HardwareBreakout/BluetoothLowEnergyBoosterPack/Hardware/BLE Booster V3_0.jpg

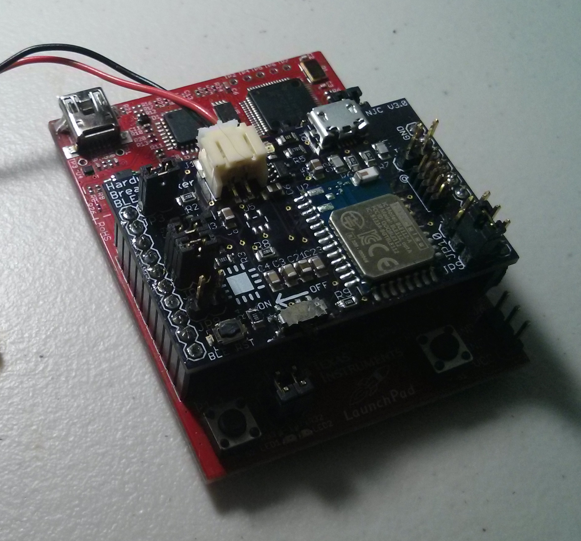
Hardware/BLE Booster V3_0.jpg
