HardwareBreakout/BluetoothLowEnergyBoosterPack/Hardware/BLE Booster 00 V2_0.jpg

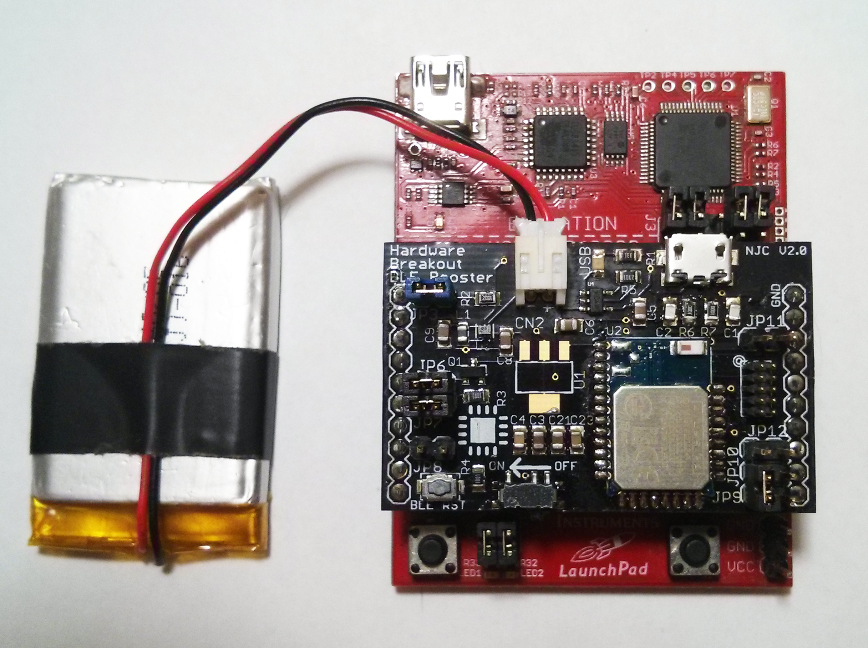
Hardware/BLE Booster 00 V2_0.jpg
