HardwareBreakout/BluetoothLowEnergyBoosterPack/Hardware/Footprint BLE BoosterPack V3_1.pdf

## PCB Footprint: Bluetooth Low Energy BoosterPack – V3.1

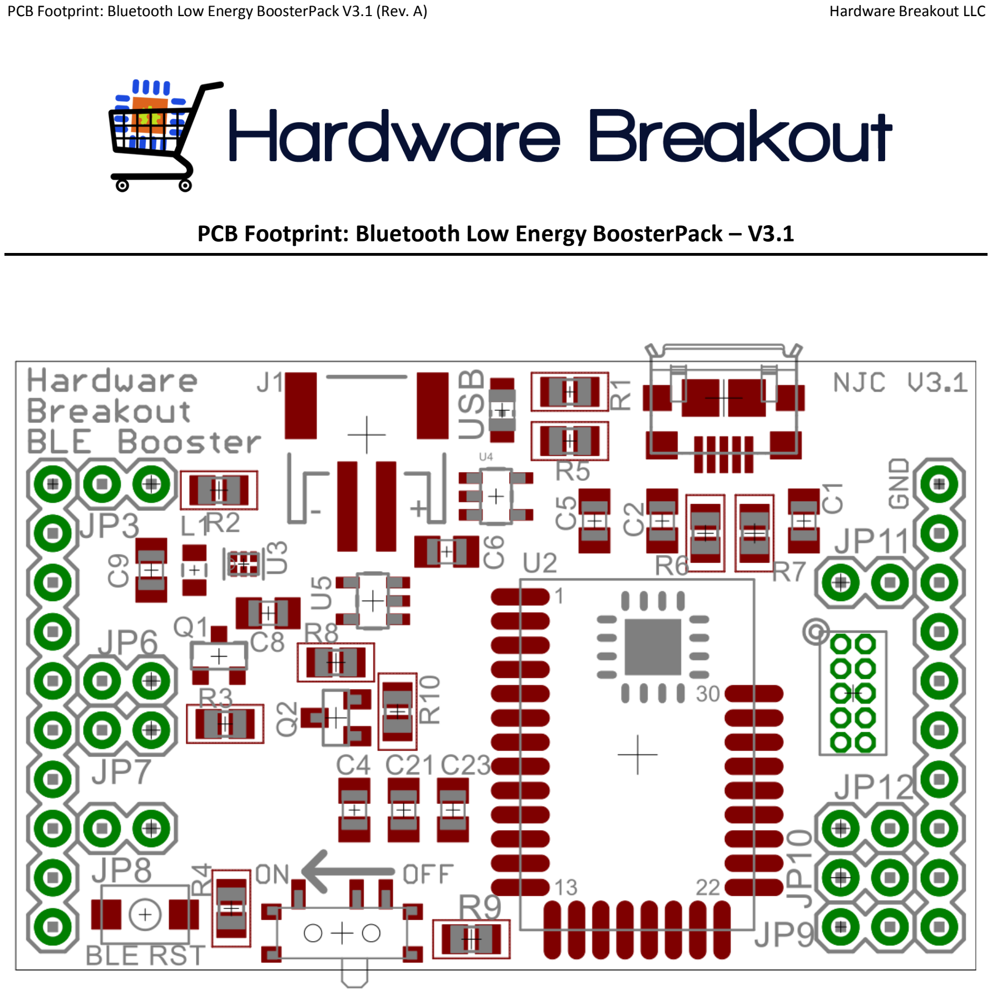
[picture p3: page 1]

PCB Footprint: Bluetooth Low Energy BoosterPack V3.1 (Rev. A) | Hardware Breakout LLC
