HardwareBreakout/BluetoothLowEnergyBoosterPack/Hardware/Footprint BLE BoosterPack V3_0.pdf

## PCB Footprint: Bluetooth Low Energy BoosterPack – V3.0

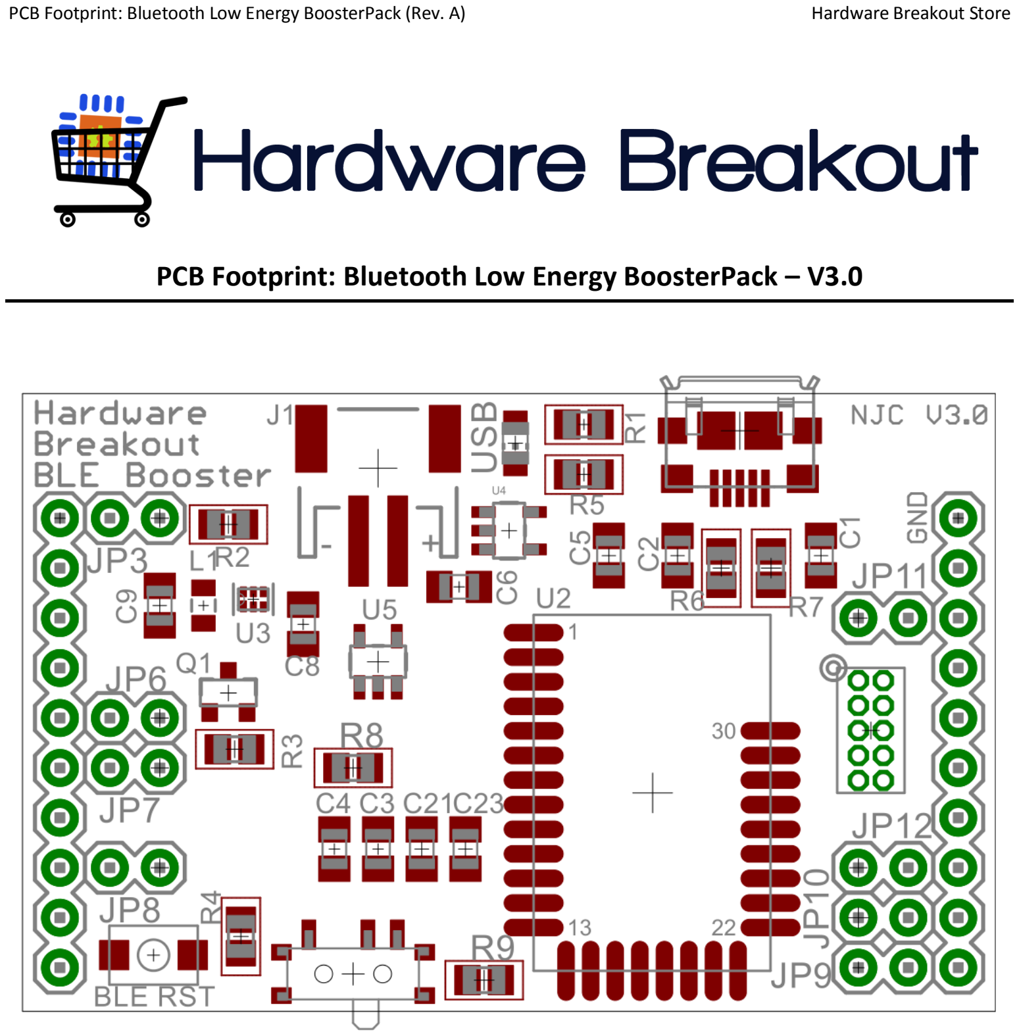
[picture p4: page 1]

PCB Footprint: Bluetooth Low Energy BoosterPack (Rev. A) | Hardware Breakout Store
