HardwareBreakout/BluetoothLowEnergyBoosterPack/Android Example App/BluetoothLowEnergyDemo/ic_launcher-web.png

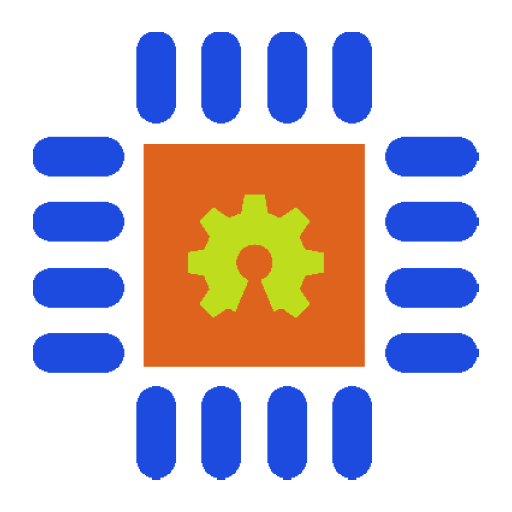
Android Example App/BluetoothLowEnergyDemo/ic_launcher-web.png
