HardwareBreakout/BluetoothLowEnergyBoosterPack/Hardware/BLE Booster 01 V3_0.jpg

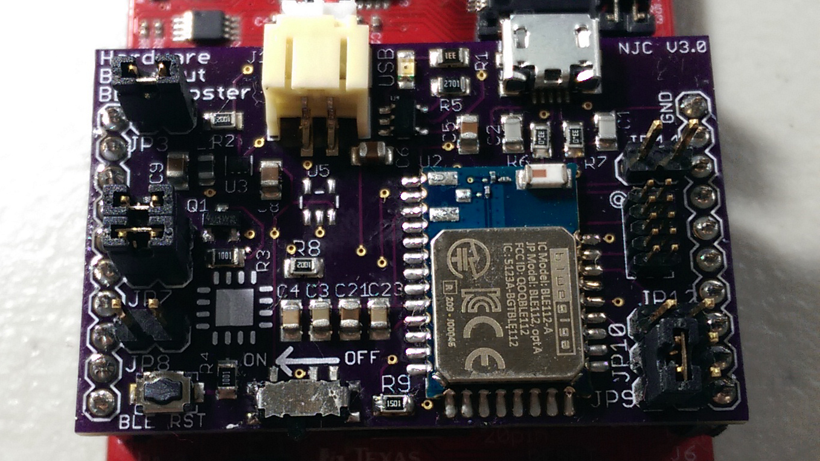
Hardware/BLE Booster 01 V3_0.jpg
