HardwareBreakout/BluetoothLowEnergyBoosterPack/Pinout V3_0.png

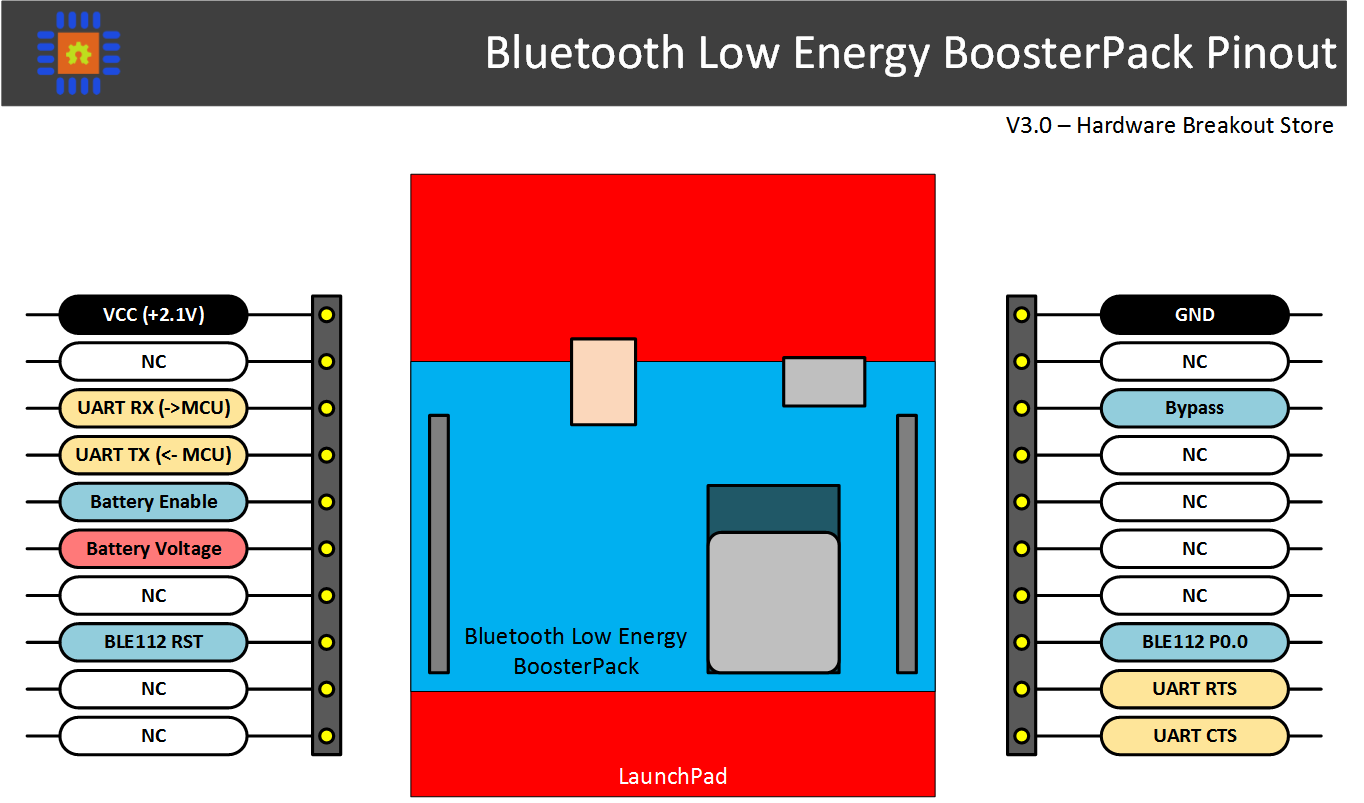
Pinout V3_0.png
