HardwareBreakout/BluetoothLowEnergyBoosterPack/Hardware/BOM BLE BoosterPack V3_1.xlsx

Description | Value | Mouser Number
Capacitor 0805 | 0.001uF
Capacitor 0805 | 0.1uF
Capacitor 0805 | 2.2uF
Capacitor 0805 | 4.7uF
Capacitor 0805 | 47pF
Resistor 0805 | 33R
Resistor 0805 | 330R
Resistor 0805 | 1.5k
Resistor 0805 | 2k
Resistor 0805 | 10k
Inductor | 2.2uH | 810-MLZ2012A2R2W
LED | Red | 720-LHR974-LP-1
Transistor | PMOS | 771-PMV160UP215
Transistor | NMOS | 771-NX3008NBK,215
Switch | Toggle | 688-SSSS810701
Switch | Push | 612-TL1015AF
Connector | 0.05" 2x5 | 649-221111-00010T4LF
Connector | uUSB | 649-10118192-0001LF
Connector | LiPo | 455-1749-1-ND (DigiKey)
Header | Female 1x10 | 992-10FX1-254MM
Header | 8x 2 pin jump | 649-68000-236HLF
Regulator | LP5907 3.3V | LP5907MFX-3.3/NOPB
Regulator | TPS62730 | 595-TPS62730DRYT
Charger | MCP73831 | 579-MCP73831T-2ACIOT
Bluetooth | BLE112 | 603-BLE112-A
Jumper | 2 Pin | 806-SX1100-B
