HardwareBreakout/BluetoothLowEnergyBoosterPack/Hardware/BOM V3_0.xlsx

Sheet: V1
Description | Value | Total Quantity | Mouser Number | Unit Cost | Full Board | Cost | LDO | Cost | BLE Only | Cost | Notes | Unit Cost 50 | Full Board 50 | Cost
Capacitor | 0.001uF | 1 |  | $0.06 | 1 | $0.06 | 1 | $0.06 | 1 | $0.06 |  | $0.04 | 1 | $0.04
Capacitor | 0.1uF | 1 |  | $0.06 | 1 | $0.06 | 1 | $0.06 | 1 | $0.06 |  | $0.04 | 1 | $0.04
Capacitor | 1uF | 1 |  | $0.06 | 1 | $0.06 | 1 | $0.06 | 1 | $0.06 |  | $0.04 | 1 | $0.04
Capacitor | 2.2uF | 2 |  | $0.06 | 2 | $0.12 | 2 | $0.12 | 1 | $0.06 |  | $0.04 | 2 | $0.07
Capacitor | 4.7uF | 3 |  | $0.06 | 3 | $0.18 | 3 | $0.18 | 1 | $0.06 |  | $0.04 | 3 | $0.11
Resistor | 330R | 1 |  | $0.08 | 1 | $0.08 | 1 | $0.08 | 1 | $0.08 |  | $0.01 | 1 | $0.01
Resistor | 1k | 2 |  | $0.08 | 2 | $0.16 | 2 | $0.16 | 0 | $0.00 |  | $0.01 | 2 | $0.02
Resistor | 2k | 1 |  | $0.08 | 1 | $0.08 | 1 | $0.08 | 0 | $0.00 |  | $0.01 | 1 | $0.01
Resistor | 10k | 1 |  | $0.08 | 1 | $0.08 | 0 | $0.00 | 0 | $0.00 |  | $0.01 | 1 | $0.01
Inductor | 2.2uH | 1 | 810-MLZ2012A2R2W | $0.13 | 1 | $0.13 | 0 | $0.00 | 0 | $0.00 |  | $0.10 | 1 | $0.10
LED | Red | 1 | 720-LHR974-LP-1 | $0.10 | 1 | $0.10 | 1 | $0.10 | 0 | $0.00 |  | $0.04 | 1 | $0.04
Transistor | PMOS | 1 | 771-PMV160UP215 | $0.07 | 1 | $0.07 | 1 | $0.07 | 0 | $0.00 |  | $0.07 | 1 | $0.07
Switch | Toggle | 1 | 688-SSSS810701 | $0.37 | 1 | $0.37 | 1 | $0.37 | 0 | $0.00 |  | $0.31 | 1 | $0.31
Switch | Push | 1 | 612-TL1015AF | $0.66 | 1 | $0.66 | 1 | $0.66 | 1 | $0.66 |  | $0.53 | 1 | $0.53
Connector | 0.05" 2x5 | 1 | 649-221111-00010T4LF | $0.70 | 1 | $0.70 | 1 | $0.70 | 1 | $0.70 |  | $0.58 | 1 | $0.58
Connector | uUSB | 1 | 649-10118192-0001LF | $0.35 | 1 | $0.35 | 1 | $0.35 | 0 | $0.00 |  | $0.29 | 1 | $0.29
Connector | LiPo | 1 | SparkFun PRT-0861 | $0.95 | 1 | $0.95 | 1 | $0.95 | 0 | $0.00 | Find at Mouser or Digikey | $0.86 | 1 | $0.86
Header | Female 1x10 | 2 | 992-10FX1-254MM | $0.70 | 2 | $1.40 | 2 | $1.40 | 2 | $1.40 | Find Stackable if possible | $0.68 | 2 | $1.37
Header | 2x8 | 1 | 649-77313-418-16LF | $0.44 | 1 | $0.44 | 1 | $0.44 | 1 | $0.44 | Look for larger ones for production | $0.36 | 1 | $0.36
Regulator | TLV1117 | 0 | 595-TLV1117-50CDCYR | $0.64 | 0 | $0.00 | 1 | $0.64 | 0 | $0.00 |  | $0.38 | 0 | $0.00
Regulator | TPS62730 | 1 | 595-TPS62730DRYT | $1.96 | 1 | $1.96 | 0 | $0.00 | 0 | $0.00 |  | $1.37 | 1 | $1.37
Charger | MCP73831 | 1 | 579-MCP73831T-2ACIOT | $0.60 | 1 | $0.60 | 1 | $0.60 | 0 | $0.00 |  | $0.47 | 1 | $0.47
Bluetooth | BLE112 | 1 | 603-BLE112-A | $14.80 | 1 | $14.80 | 1 | $14.80 | 1 | $14.80 |  | $14.25 | 1 | $14.25
Jumper | 2 Pin | 8 | 806-SX1100-B | $0.03 | 8 | $0.24 | 8 | $0.24 | 5 | $0.15 |  | $0.02 | 8 | $0.16
PCB | 1.975x1.075 in | 1 | OSH Park Medium Run | $3.05 | 1 | $3.05 | 1 | $3.05 | 1 | $3.05 | This is for 150 in sq minimum | $3.05 | 1 | $3.05
Shipping | Cost + Package | 1 | USPS | $3.00 | 1 | $3.00 | 1 | $3.00 | 1 | $3.00 |  | $3.00 | 1 | $3.00
 |  |  |  |  |  | $29.70 |  | $28.17 |  | $24.58 |  |  |  | $27.12
 | Full Board | LDO | BLE Only | T-Shirt
Total Unit Cost | $29.70 | $28.17 | $24.58 | $10.20
Sell Price | $60.00 | 50 | $35.00 | $20.00
Profit | $30.30 | $21.83 | $10.42 | $9.80
Percent Profit | 50.5% | 43.66% | 29.77142857% | 49%

Sheet: V2
Description | Value | Mouser Number
Capacitor 0805 | 0.001uF
Capacitor 0805 | 0.1uF
Capacitor 0805 | 1uF
Capacitor 0805 | 2.2uF
Capacitor 0805 | 4.7uF
Capacitor 0805 | 47pF
Resistor 0805 | 33R
Resistor 0805 | 330R
Resistor 0805 | 1k
Resistor 0805 | 2k
Resistor 0805 | 10k
Inductor | 2.2uH | 810-MLZ2012A2R2W
LED | Red | 720-LHR974-LP-1
Transistor | PMOS | 771-PMV160UP215
Switch | Toggle | 688-SSSS810701
Switch | Push | 612-TL1015AF
Connector | 0.05" 2x5 | 649-221111-00010T4LF
Connector | uUSB | 649-10118192-0001LF
Connector | LiPo | 455-1749-1-ND (DigiKey)
Header | Female 1x10 | 992-10FX1-254MM
Header | 8x 2 pin jump | 649-68000-236HLF
Regulator | LP5907 3.3V | LP5907MFX-3.3/NOPB
Regulator | TPS62730 | 595-TPS62730DRYT
Charger | MCP73831 | 579-MCP73831T-2ACIOT
Bluetooth | BLE112 | 603-BLE112-A
Jumper | 2 Pin | 806-SX1100-B
