HardwareBreakout/BluetoothLowEnergyBoosterPack/Trinket Pro Shield/Pro Trinket BLE Shield V1_0 - Schematic.pdf

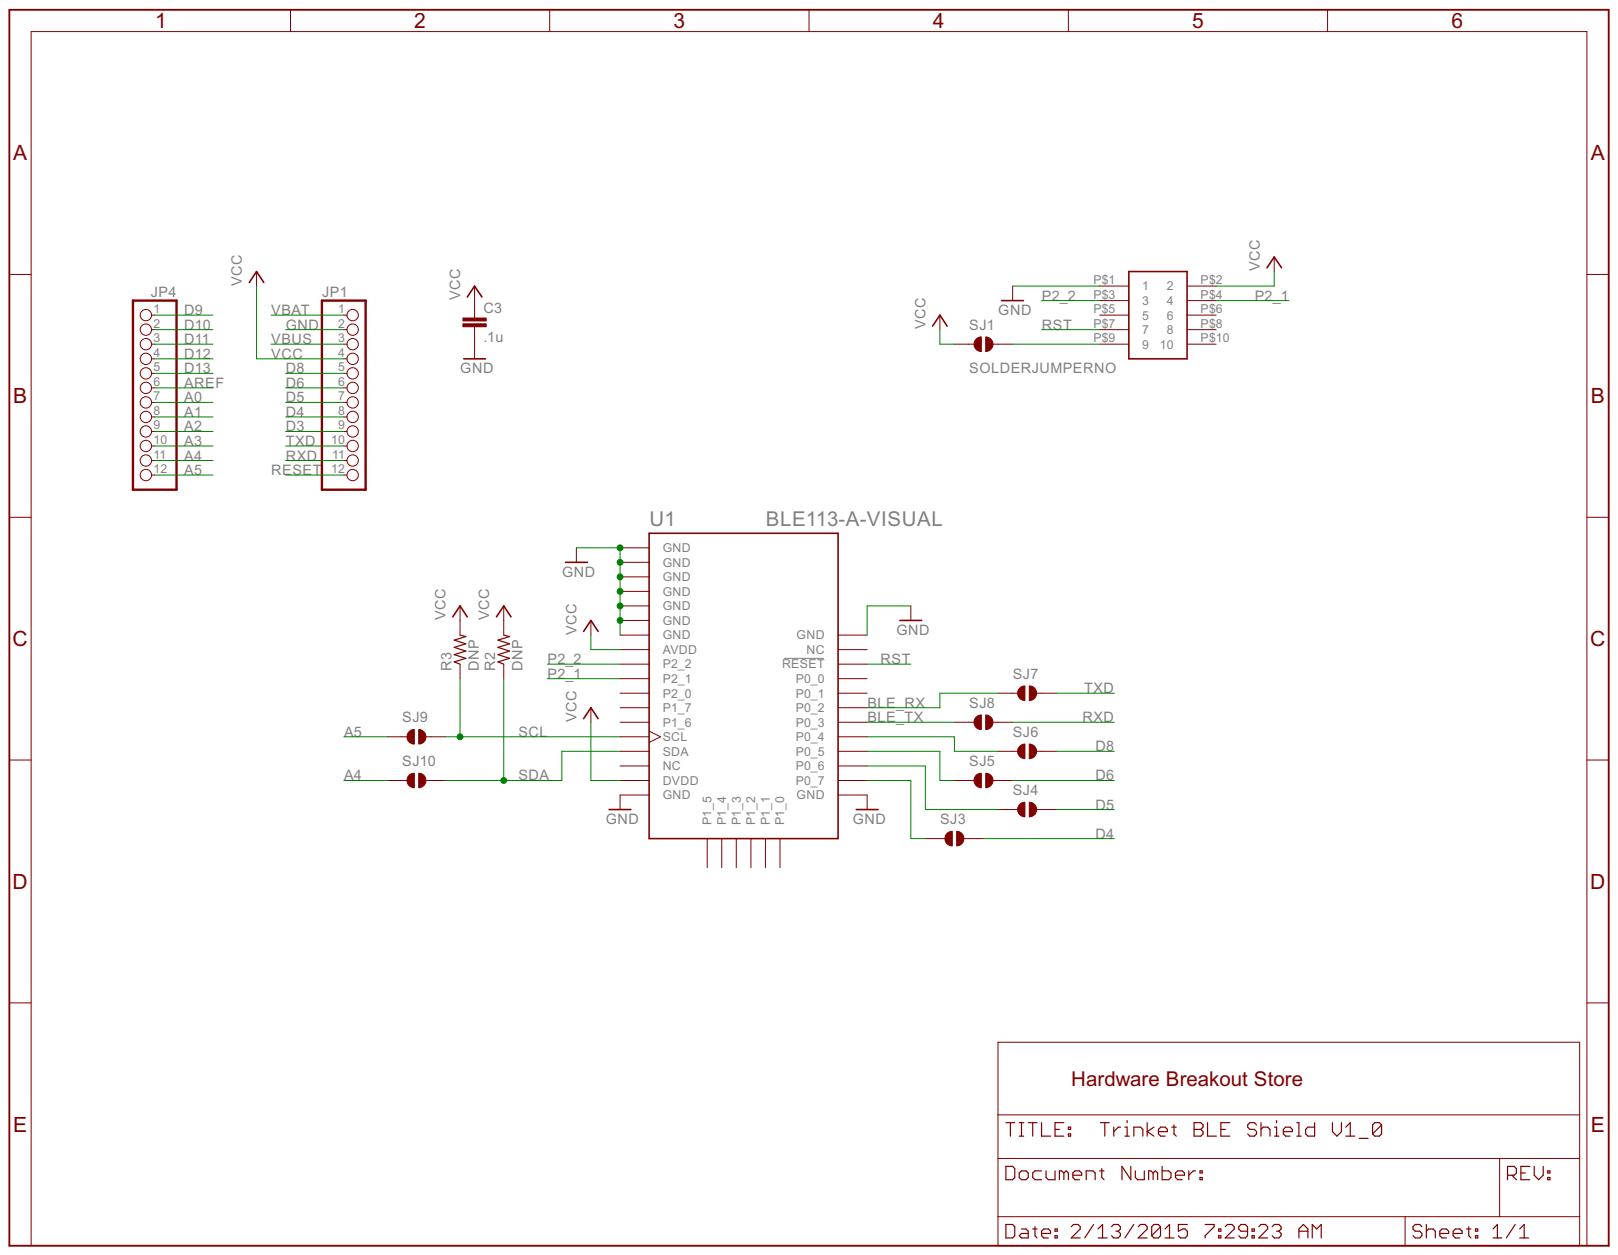
[picture p27: page 1]

GND
GND GND GND
