HardwareBreakout/BluetoothLowEnergyBoosterPack/Hardware/Schematic BLE BoosterPack V3_1.pdf

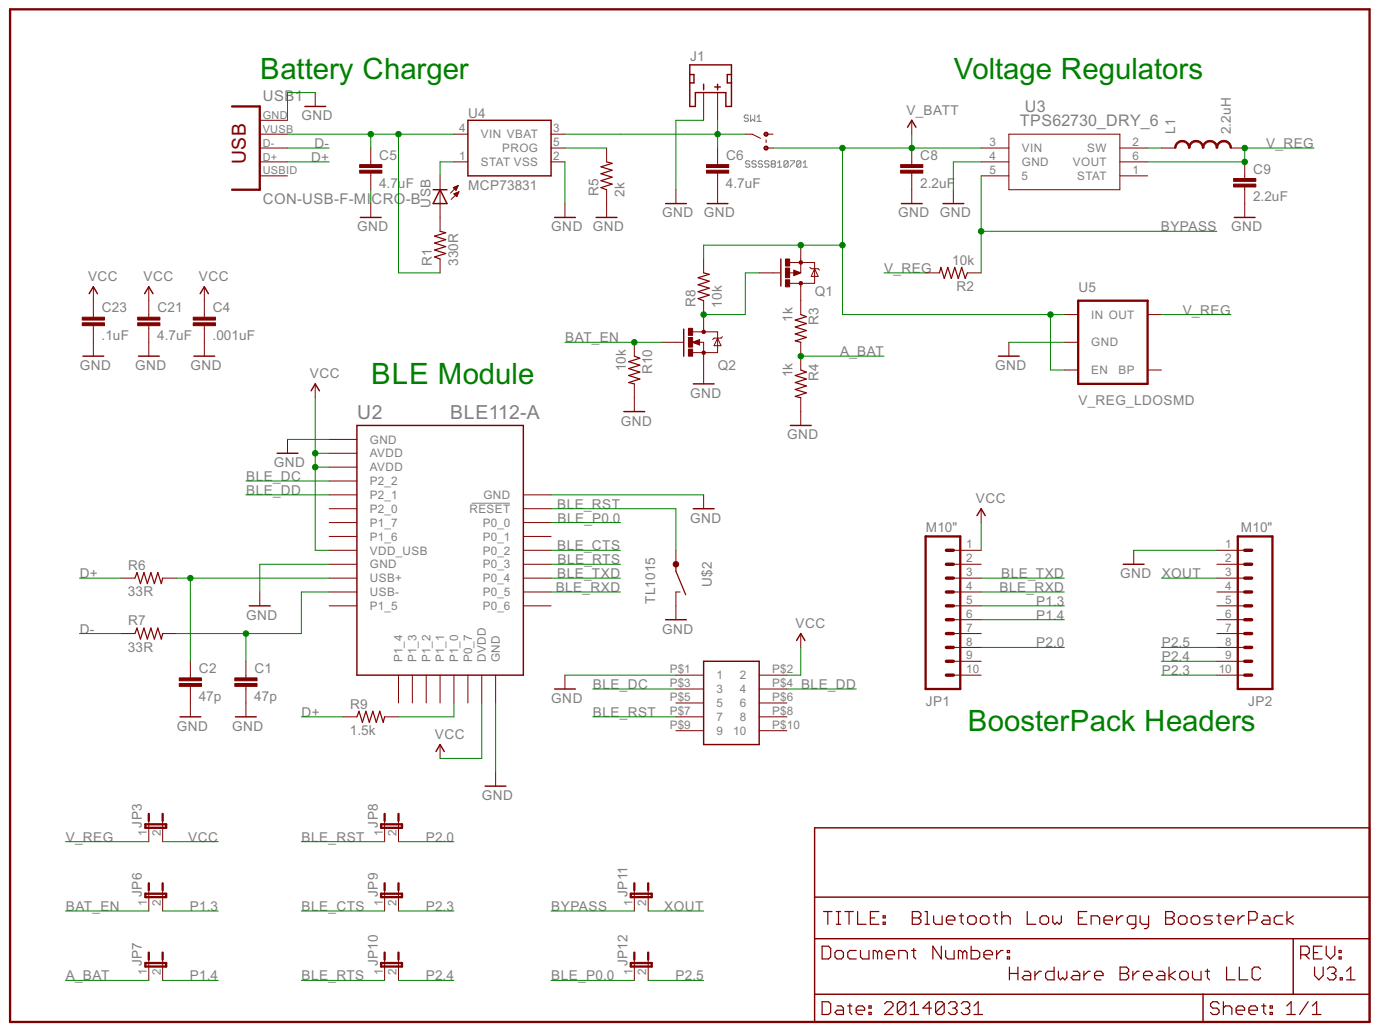
[picture p28: page 1]
