HardwareBreakout/BluetoothLowEnergyBoosterPack/Hardware/BLE_BOOST_V3_0.pdf

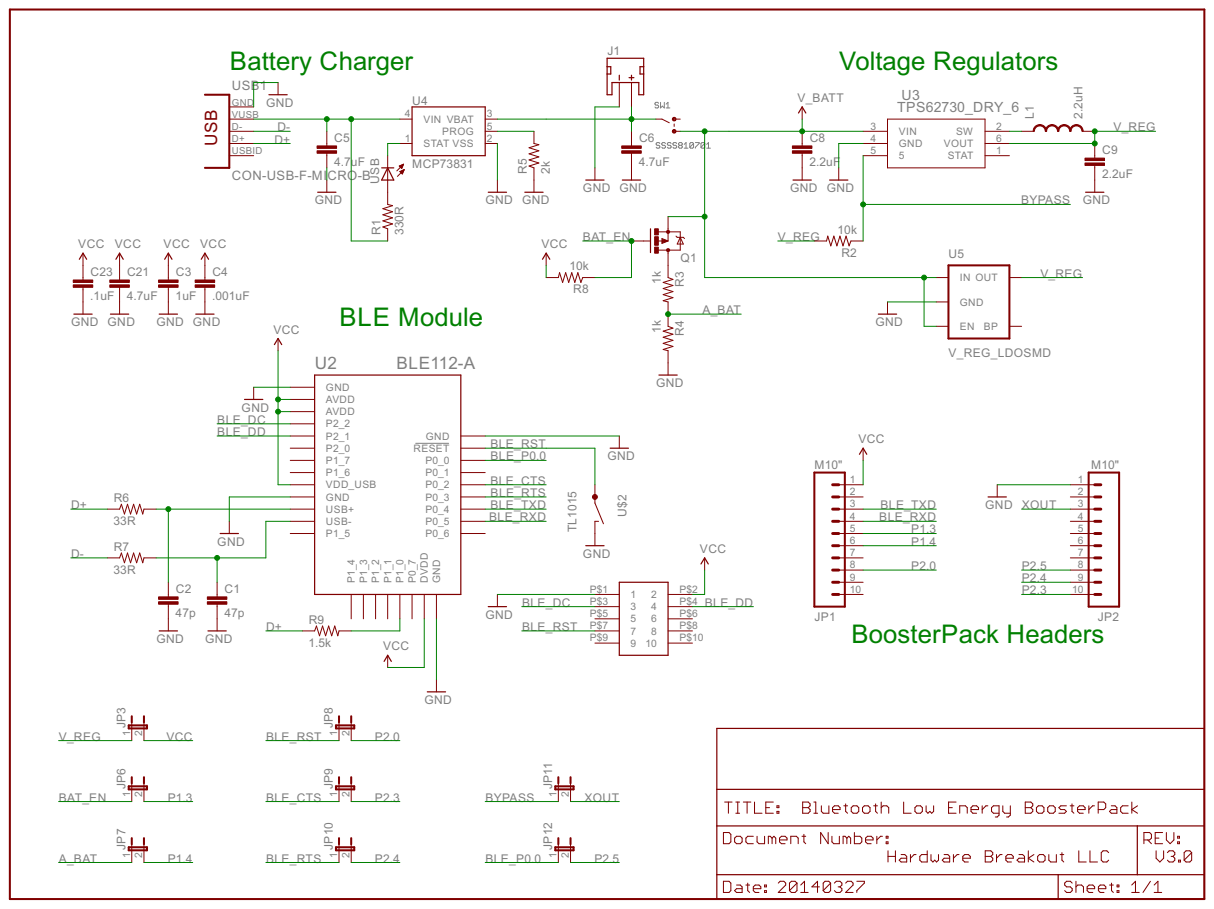
[picture p29: page 1]
