HardwareBreakout/BluetoothLowEnergyBoosterPack/(commit log)

2014-03-27 Initial commit for the BLE BoosterPack respository on GitHub. Current hardware version is V3.0.
    [BOM V3_0.xlsx]
2014-03-31 Updated hardware to V3.1. This fixed the MOSFET issue. New hardware files were updated.
    [BOM BLE BoosterPack V3_1.xlsx, BOM V3_0.xlsx]
2014-03-31 Added extra figures and updated the BOM for V3.1.
    [BOM BLE BoosterPack V3_1.xlsx]
2014-04-07 Added BLE112 firmware for UART passthrough with flow control enabled.
    [BOM V3_0.xlsx]
